Funny-Mech/Combat_Car/装配体.SLDASM

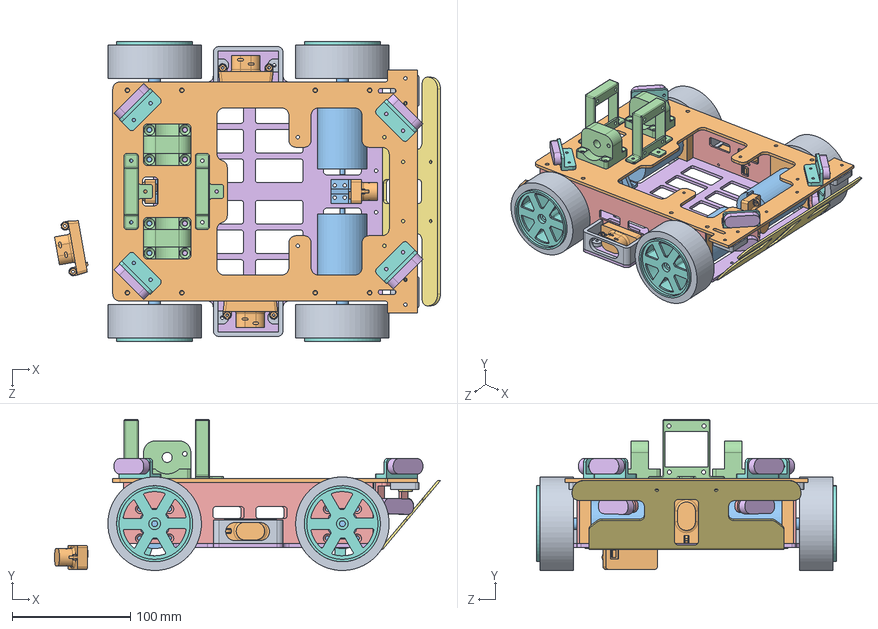
[picture p2: CAD file, 2026-11-03]
装配体.SLDASM
325.9 x 127.5 x 253.0 mm
上甲板
TOF 支架 x 2
点阵支架前 x 4
TOF 200F x 2
点阵激光 x 6
点阵支架后 x 2
openmv盒子 x 2
motor x 4
电机套(薄) x 4
轮胎图块 x 4
轮子 9.2增大版 x 4
斜面(1)
地板
左右甲板（左板） x 2
轴承座 x 2
传感器壳子 x 2
激光测距模块(1) x 5
盖子侧面 x 2
