Funny-Mech/Combat_Car/盖子侧面.SLDPRT

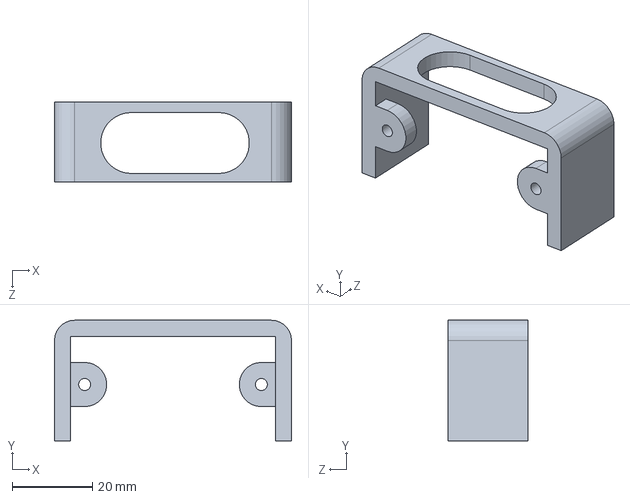
[picture p3: CAD file, 2026-11-03]
盖子侧面.SLDPRT
59.0 x 30.0 x 20.0 mm
