Funny-Mech/Combat_Car/左右甲板（左板）.SLDPRT

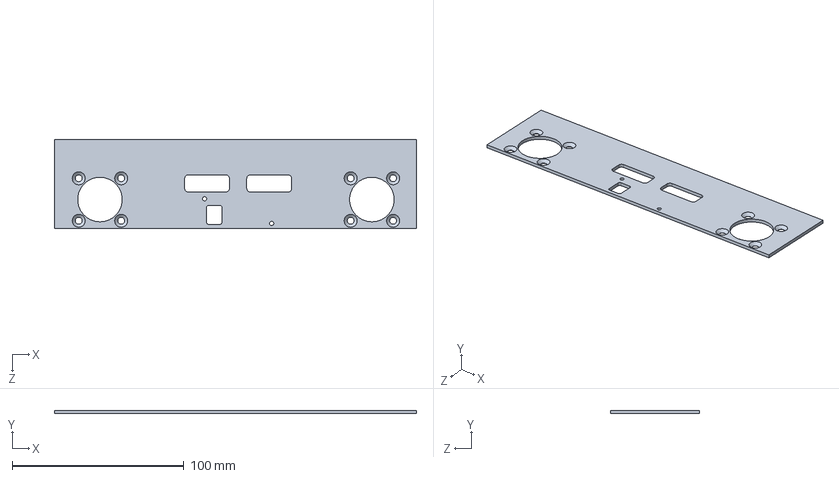
[picture p4: CAD file, 2026-11-03]
左右甲板（左板）.SLDPRT
211.0 x 2.00 x 51.9 mm
