Funny-Mech/Combat_Car/上甲板.SLDPRT

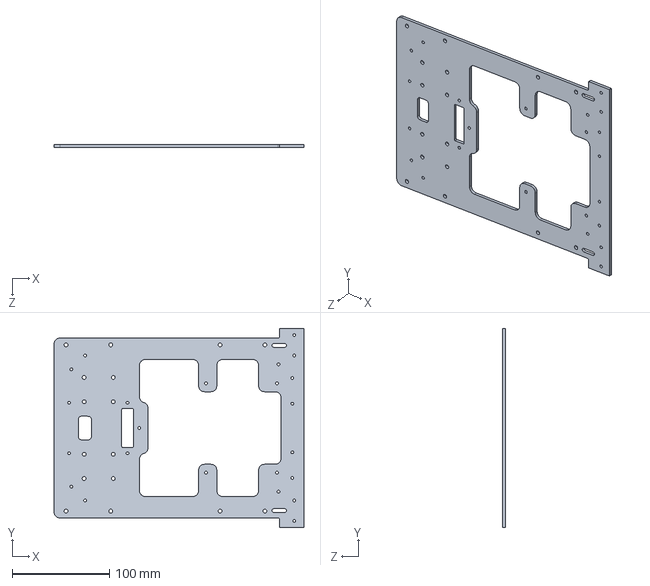
[picture p5: CAD file, 2026-11-03]
上甲板.SLDPRT
257.2 x 205.0 x 3.00 mm
