Funny-Mech/Combat_Car/轮子 9.2增大版.SLDPRT

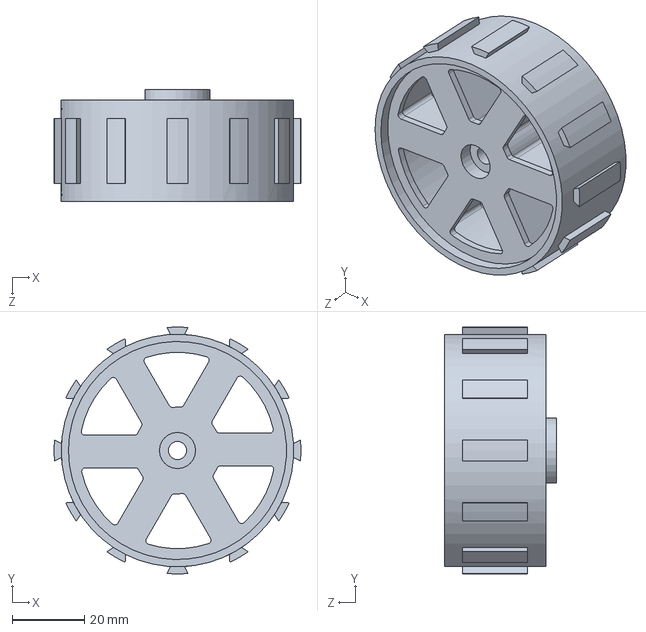
[picture p6: CAD file, 2026-11-03]
轮子 9.2增大版.SLDPRT
68.2 x 68.2 x 31.0 mm
