Funny-Mech/Combat_Car/TOF 200F.SLDPRT

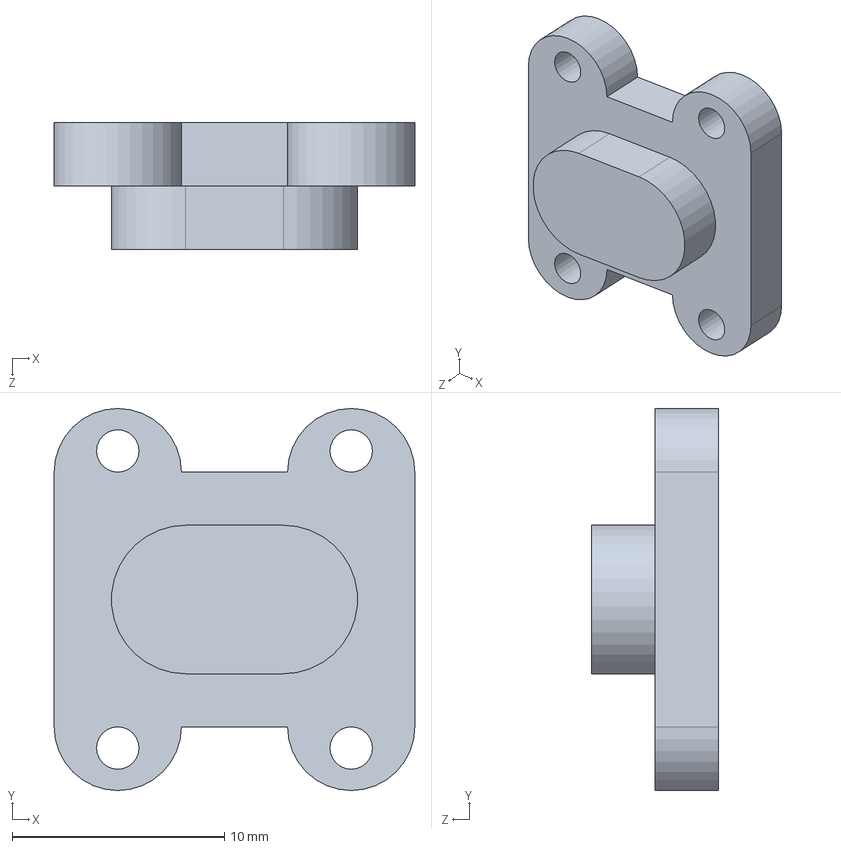
[picture p7: CAD file, 2026-11-03]
TOF 200F.SLDPRT
17.0 x 18.0 x 6.00 mm
