Funny-Mech/Combat_Car/挡板.SLDPRT

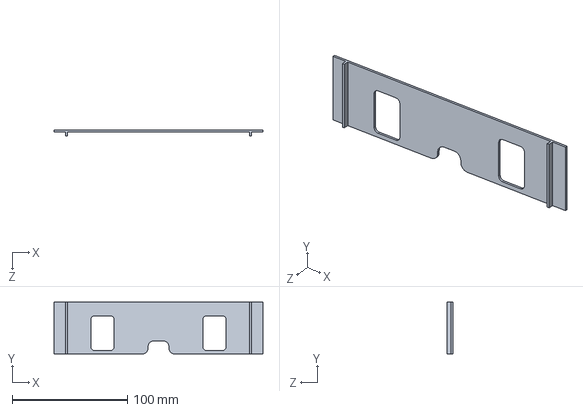
[picture p8: CAD file, 2026-11-03]
挡板.SLDPRT
181.0 x 45.0 x 5.00 mm
