Funny-Mech/Combat_Car/内六角平圆头螺钉M3×8].sldprt

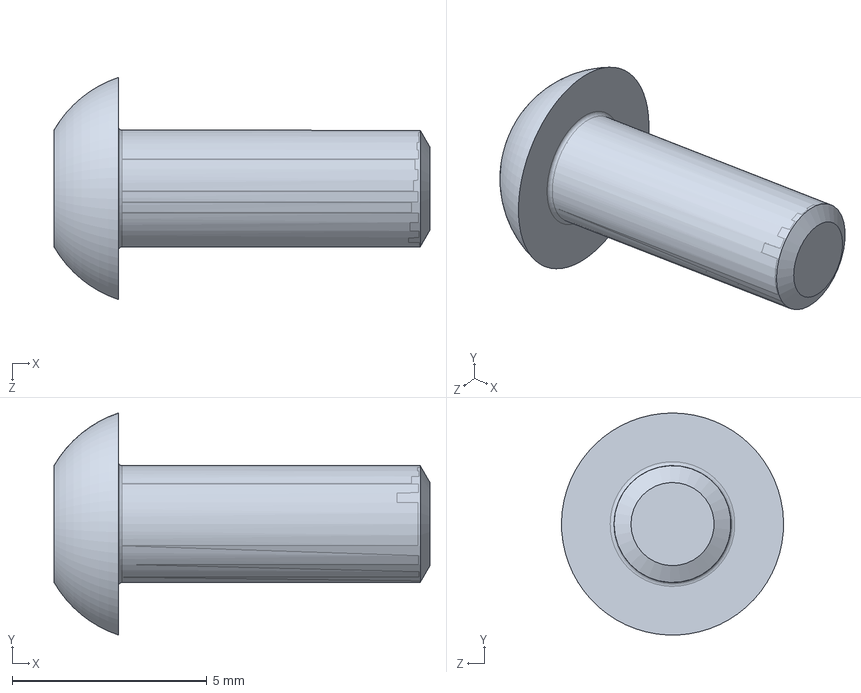
[picture p9: CAD file, 2026-11-03]
内六角平圆头螺钉M3×8].sldprt
9.65 x 5.70 x 5.70 mm
