Funny-Mech/Combat_Car/轴承座.SLDPRT

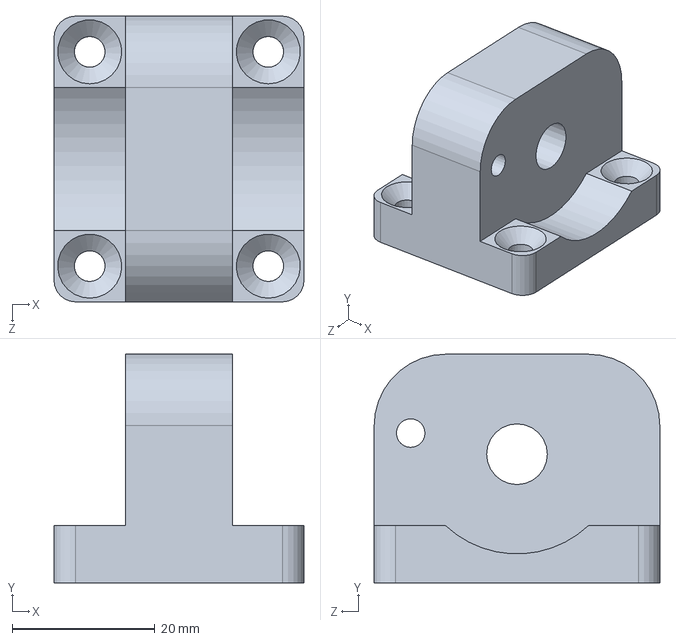
[picture p10: CAD file, 2026-11-03]
轴承座.SLDPRT
35.0 x 32.0 x 40.0 mm
