Funny-Mech/Combat_Car/点阵激光.SLDPRT

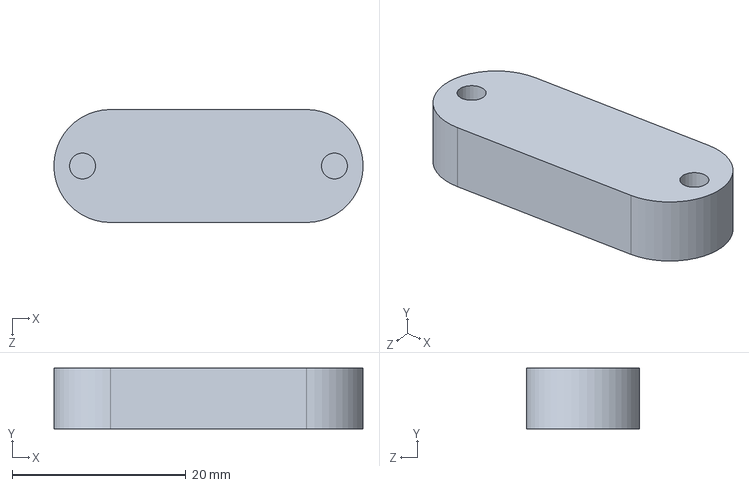
[picture p11: CAD file, 2026-11-03]
点阵激光.SLDPRT
35.6 x 7.00 x 13.0 mm
