Funny-Mech/Combat_Car/内六角平圆头螺钉M4×12].sldprt

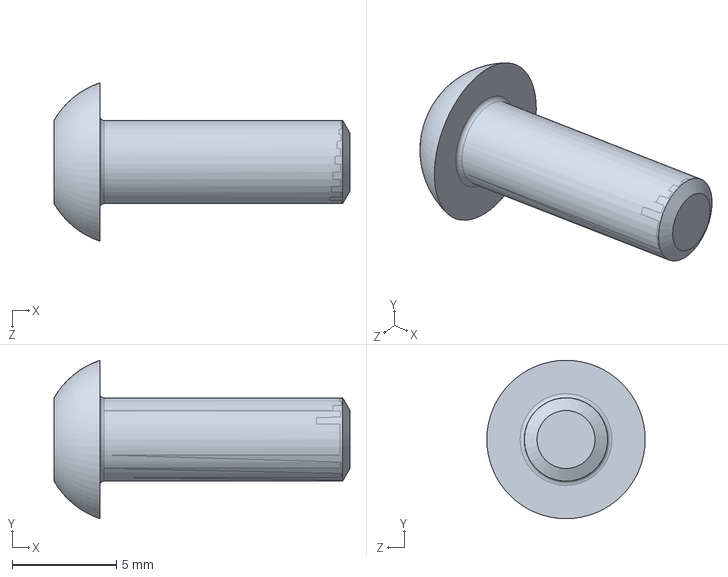
[picture p12: CAD file, 2026-11-03]
内六角平圆头螺钉M4×12].sldprt
14.2 x 7.60 x 7.60 mm
