Funny-Mech/Combat_Car/新后传感器支架.SLDPRT

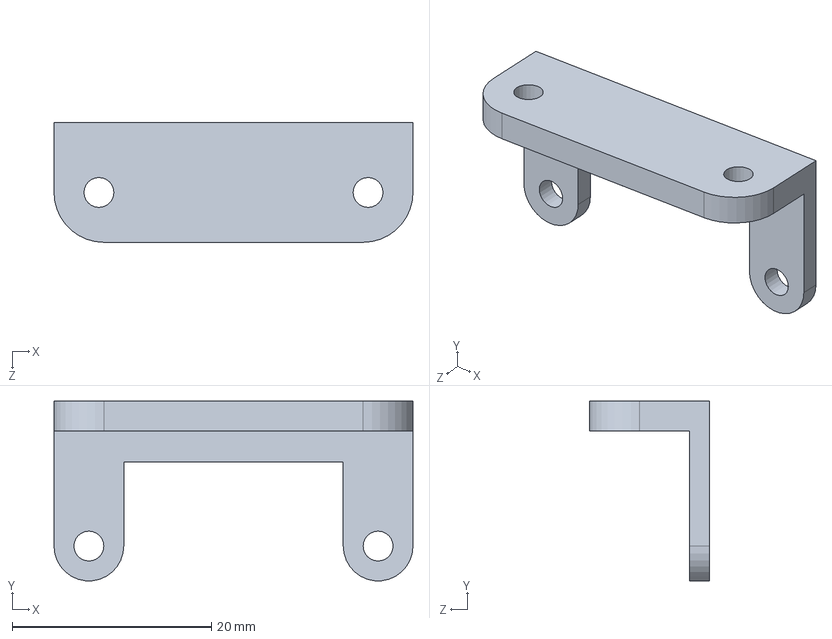
[picture p13: CAD file, 2026-11-03]
新后传感器支架.SLDPRT
36.0 x 18.0 x 12.0 mm
