Funny-Mech/Combat_Car/TOF 支架.SLDPRT

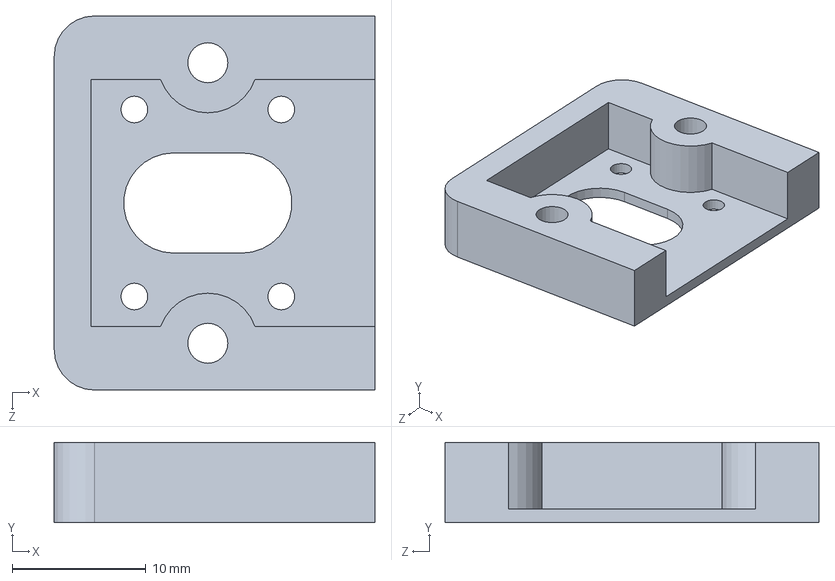
[picture p14: CAD file, 2026-11-03]
TOF 支架.SLDPRT
24.0 x 6.00 x 28.0 mm
