Funny-Mech/Combat_Car/传感器壳子.SLDPRT

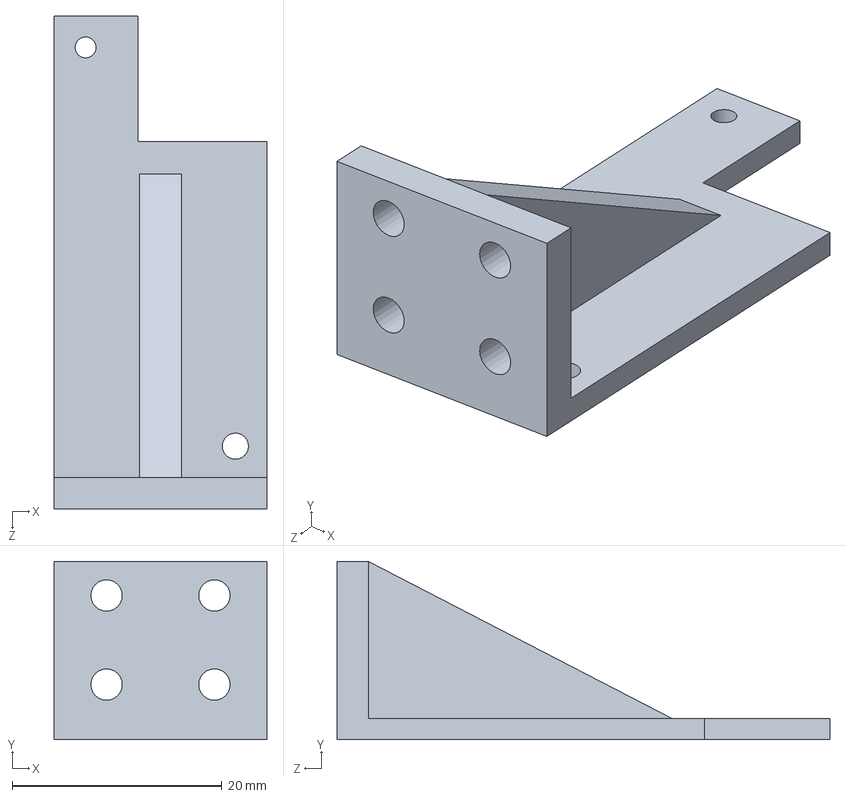
[picture p15: CAD file, 2026-11-03]
传感器壳子.SLDPRT
20.3 x 17.0 x 47.1 mm
