Funny-Mech/Combat_Car/电机套(薄).SLDPRT

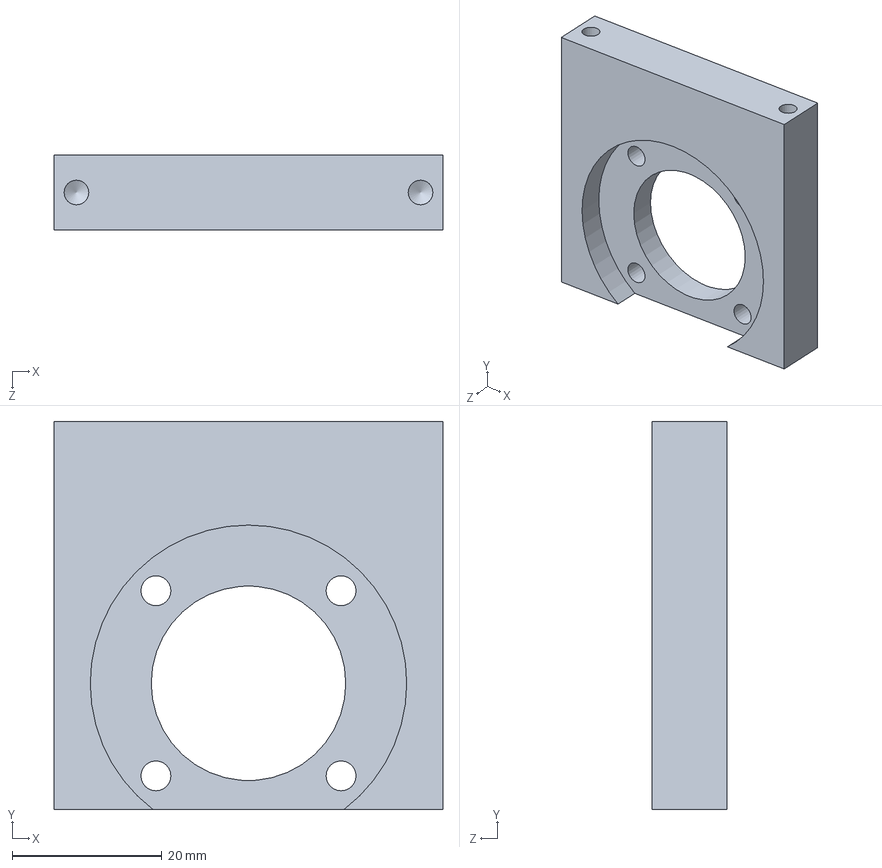
[picture p16: CAD file, 2026-11-03]
电机套(薄).SLDPRT
52.0 x 51.9 x 10.0 mm
