Funny-Mech/Combat_Car/轮胎图块.SLDPRT

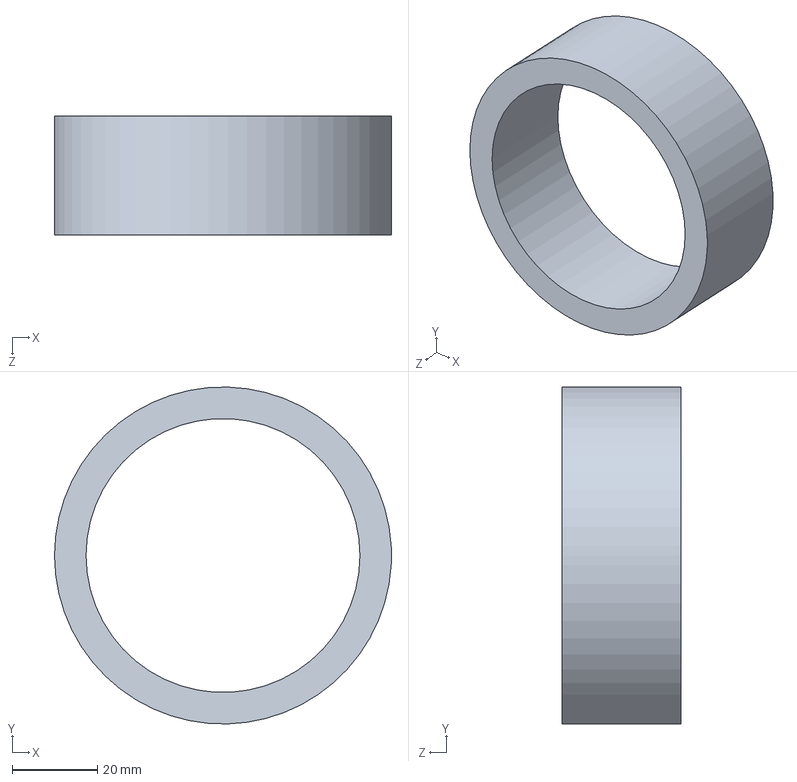
[picture p17: CAD file, 2026-11-03]
轮胎图块.SLDPRT
79.0 x 79.0 x 28.0 mm
