Funny-Mech/Combat_Car/点阵支架后.SLDPRT

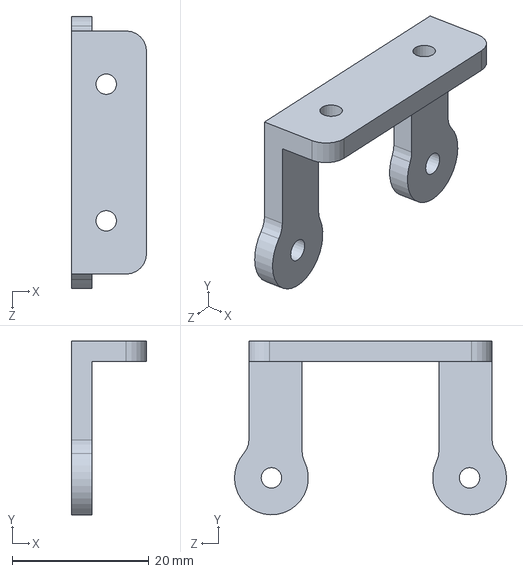
[picture p18: CAD file, 2026-11-03]
点阵支架后.SLDPRT
11.0 x 25.4 x 39.8 mm
