Funny-Mech/Combat_Car/地板.SLDPRT

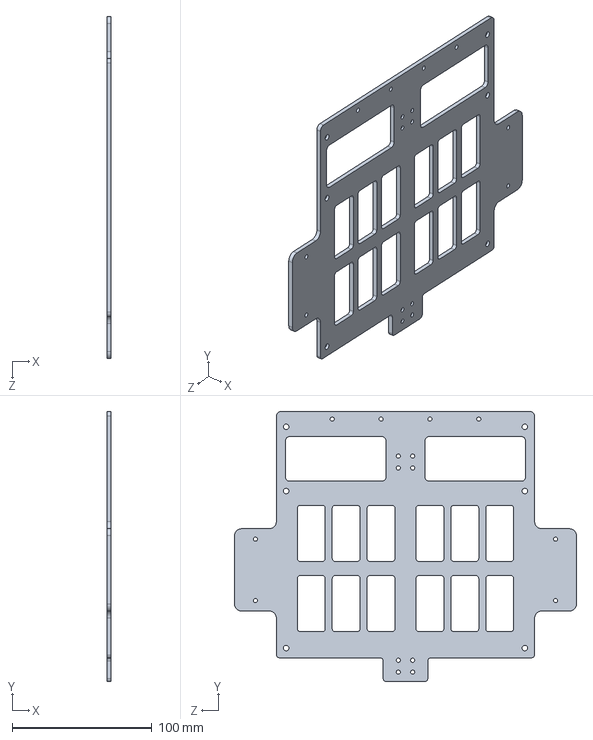
[picture p19: CAD file, 2026-11-03]
地板.SLDPRT
3.00 x 193.5 x 245.0 mm
