Funny-Mech/Combat_Car/motor.SLDPRT

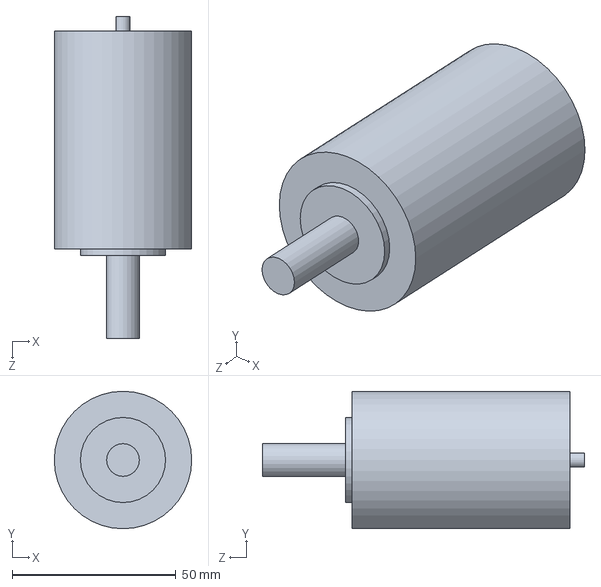
[picture p20: CAD file, 2026-11-03]
motor.SLDPRT
42.0 x 42.0 x 98.4 mm
