Funny-Mech/Combat_Car/点阵支架前.SLDPRT

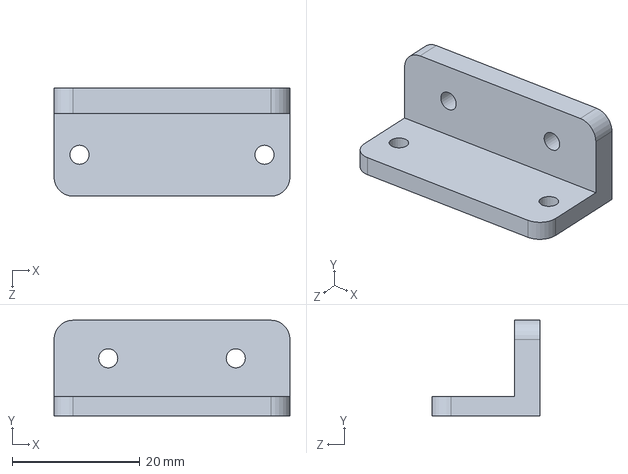
[picture p21: CAD file, 2026-11-03]
点阵支架前.SLDPRT
37.0 x 15.0 x 17.0 mm
