Funny-Mech/Combat_Car/openmv盒子.SLDPRT

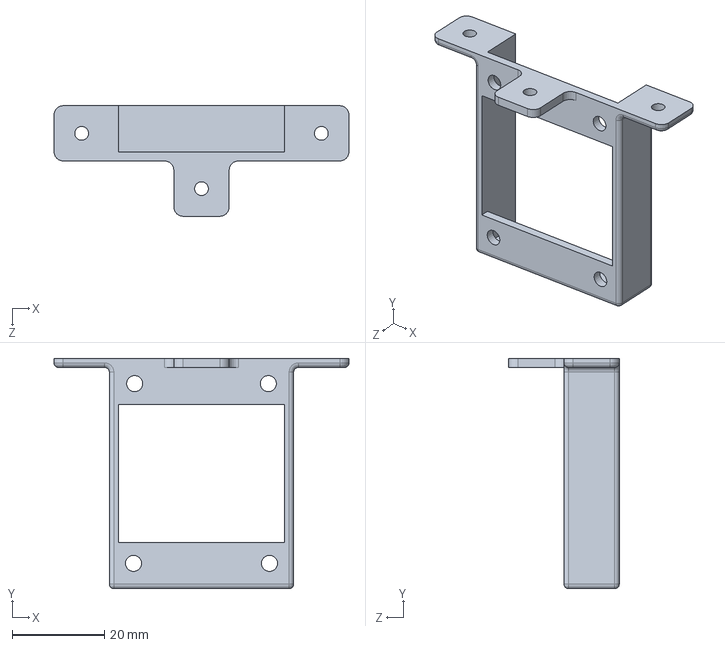
[picture p22: CAD file, 2026-11-03]
openmv盒子.SLDPRT
64.0 x 50.0 x 24.0 mm
