Funny-Mech/Combat_Car/激光测距模块(1).SLDPRT

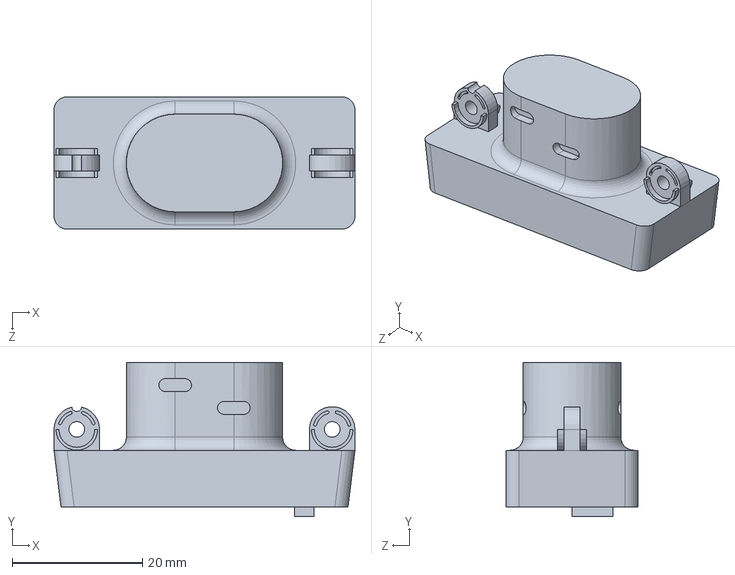
[picture p23: CAD file, 2026-11-03]
激光测距模块(1).SLDPRT
46.2 x 23.7 x 20.3 mm
