Funny-Mech/Combat_Car/斜面(1).SLDPRT

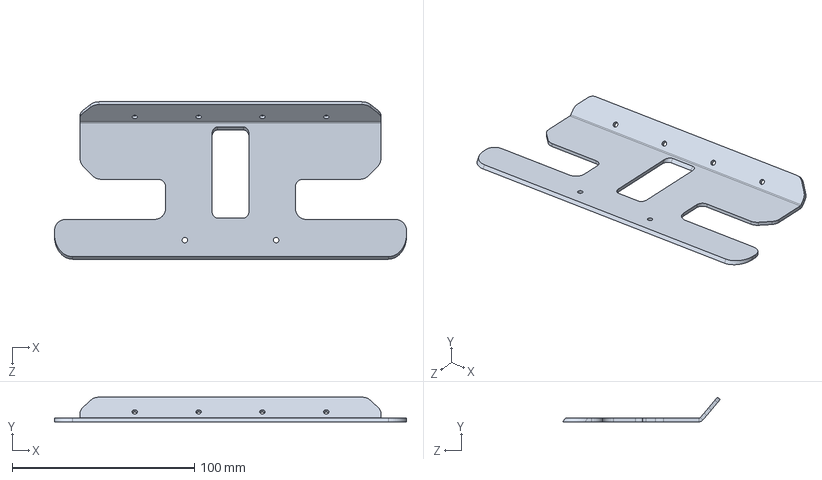
[picture p24: CAD file, 2026-11-03]
斜面(1).SLDPRT
193.0 x 13.6 x 86.4 mm
