Funny-Mech/Combat_Car/(list of files, cad)

Other CAD files:
铲子传感器.SLDPRT
